JGAguado/KiCad/README.md

[](LICENSE)
[][maintenance]

# KiCad resources
This repository repo contains resources for KiCad like:
## Project tree

<li><a href="./Symbols/">Symbols</a></li>
<li><a href="./Footprints/">Footprints</a></li>
<li><a href="./Templates/">Templates</a></li>
<li><a href="./Plugins/">Plugins</a></li>

[license-shield]: https://img.shields.io/badge/License-CC%20BY--NC--SA%204.0-lightgrey.svg?style=for-the-badge

[maintenance-shield]: https://img.shields.io/badge/maintainer-J.%20G.%20Aguado-2e48a7.svg?style=for-the-badge
[maintenance]: https://github.com/JGAguado
